synogate/gameboy-fpga-cartridge/(threads)

Thread 1 (2022-08-31):

SD-Card PullUp

moffel, 2022-08-31:
The SD-Card interface requires pull-up's on DAT0, DAT1 and DAT2 in SPI mode. The pull-up on DAT0 is missing.

During tests the SD-Card did not respond at all. When enabling the FPGA weak-pull-up the SD-Card works as expected. However the weak-pull-up has a resistance of up to 45kOhm and varies a lot. This may hinder fast SPI clock speeds and is subject to silicon lottery. We should therefore add another pull-up to DAT0.

Andreas-Ley, 2022-09-07:
I added 2k pullups to all data lines. For DAT1 and DAT2 I added two initially open solder bridges so we can still decide to pull them up or down.

Closed 2022-09-07.

Thread 3 (2022-08-31):

data level shifter has wrong pin assignments (U8)

moffel, 2022-08-31:

Closed 2022-09-07.

Thread 5 (2022-08-31):

reset should not be pulled down permanently

moffel, 2022-08-31:
DMG has a very weak 180kOhm pull-up on its reset pin. We should not pull the reset down.

Andreas-Ley, 2022-09-07:
See #7.

Thread 6 (2022-08-31):

potentiometer is too high

moffel, 2022-08-31:
The potentiometer is the highest part on the PCB. Even higher than the entire CYC1000 mounting. We should pick a smaller part.

Andreas-Ley, 2022-09-07:
I replaced it with one that is only 2.55mm high. Stock seems low on this one though (72 with our supplier).

Closed 2022-09-07.

Thread 7 (2022-08-31):

make connection between dmg reset and fpga breakable

moffel, 2022-08-31:
It is still unclear whether we can directly connect the 5V dmg reset to the fpga or not. We should at least try one more time to allow for controlled bootup and automated testing/reloading.

In case this does not work out, we should be able to break the connection easily.

Andreas-Ley, 2022-09-07:
I added an initially open solder jumper

Closed 2022-09-07.

Thread 8 (2022-08-31):

improve audio interface

moffel, 2022-08-31:
The current circuit is unable to output below 1.12V, probably due to OpAmp limitations.
It is also not capable of outputting more than 3,44V.

When turning the potentiometer, the only effect is the rise time between min and max and how long we stay in min. This indicates that the OpAmp is limited in its range.

We should consider removing the OpAmp in case we cannot find more suitable parts.

Andreas-Ley, 2022-09-07:
replaced the opamp with a rail2rail one.

Closed 2022-09-07.

Thread 9 (2022-09-01):

replace CS by more address bits

moffel, 2022-09-01:
We connected CSn to AIN. As long as we are limited in address decoding we should rather connect an additional address pin to AIN. Test with quartus indicate no problem in using this pin as input.
