synogate/gameboy-fpga-cartridge/(commit log)

2022-08-09 First full cartridge design
    [gbCartridge.kicad_pcb, gbCartridge.sch]
2022-08-09 Fab files
    [gbCartridge-B_Cu.gbl, gbCartridge-B_Mask.gbs, gbCartridge-B_Paste.gbp, gbCartridge-B_SilkS.gbo, gbCartridge-Edge_Cuts.gm1, gbCartridge-F_Cu.gtl, gbCartridge-F_Mask.gts, gbCartridge-F_Paste.gtp]
2022-08-09 Added cutout for the cartridge lock
    [gbCartridge-B_Cu.gbl, gbCartridge-B_Mask.gbs, gbCartridge-B_Paste.gbp, gbCartridge-B_SilkS.gbo, gbCartridge-Edge_Cuts.gm1, gbCartridge-F_Cu.gtl, gbCartridge-F_Mask.gts, gbCartridge-F_Paste.gtp]
2022-08-12 Layouting, selected 3d models for viewer (not all correct).
    [gbCartridge.kicad_pcb, gbCartridge.sch]
2022-09-02 Updated pin assignment for U8 (see #3) but didn't update layout yet in light of further changes.
    [gbCartridge.sch]
2022-09-06 Pullups for SD Card Data0/Data3. see #1, not yet layouted.
    [gbCartridge.sch]
2022-09-06 Added solder bridges to the reset line to be able to connect/disconnect cartridge, bus driver, and fpga reset pins. See #7. Not yet layouted.
    [gbCartridge.sch]
2022-09-06 replaced audio poti with a shorter one (2.5mm). See #6. Not yet layouted.
    [gbCartridge.sch]
2022-09-06 Replaced SD card slot with manual push-pull one. See #4. Not yet layouted.
    [gbCartridge.sch]
2022-09-07 Various changes: - OpAmp now rail2rail - Replaced level shifters with level-shifting muxes so we cann have all address lanes - Put remaining SD-card data lines on fpga pins - New PCB layout
    [gbCartridge.kicad_pcb, gbCartridge.sch]
2022-09-07 Switched one sd card lane to a different fpga pin. Also cleaned up the layout a bit.
    [gbCartridge.kicad_pcb, gbCartridge.sch]
2022-09-08 Final changes for new revision
    [gbCartridge-B_Cu.gbl, gbCartridge-B_Mask.gbs, gbCartridge-B_Paste.gbp, gbCartridge-B_SilkS.gbo, gbCartridge-Edge_Cuts.gm1, gbCartridge-F_Cu.gtl, gbCartridge-F_Mask.gts, gbCartridge-F_Paste.gtp]
2022-09-23 Restored broken schematic file
    [gbCartridge.sch]
